kingovchouffe/CANNet/OBD2_Screen/OBD2_Screen.kicad_pcb

## KiCad design OBD2_Screen/OBD2_Screen.kicad_pcb (2023-04-28)

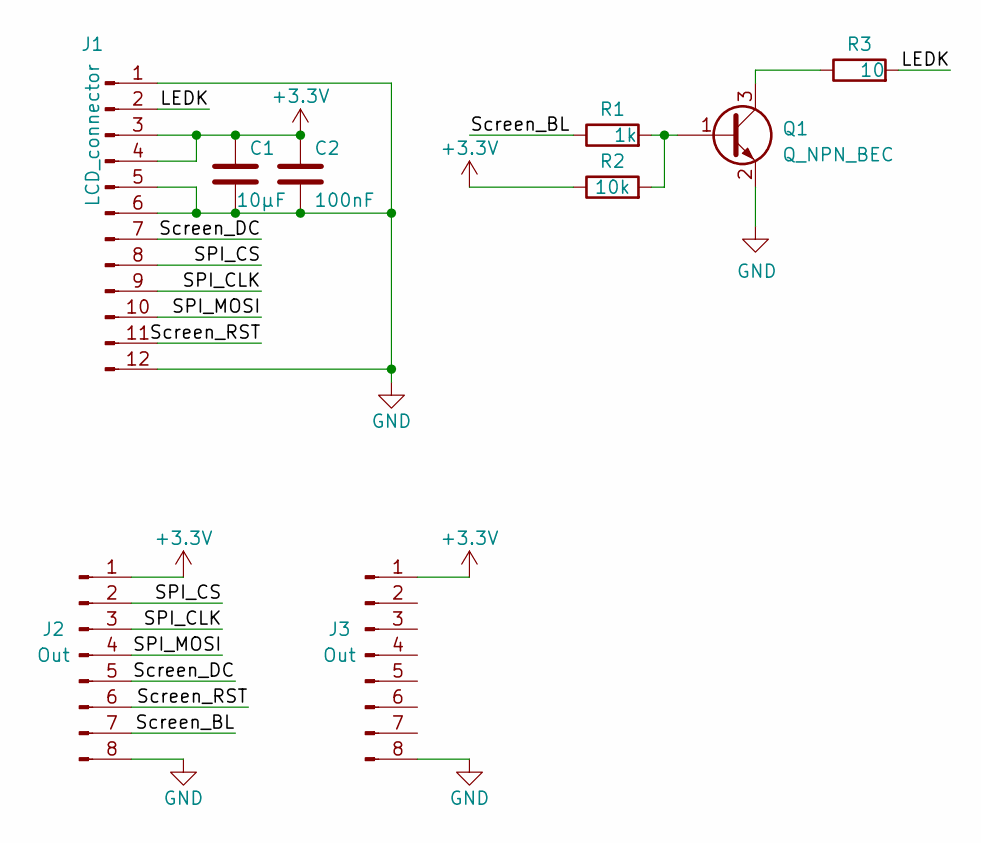
[picture p1: schematic OBD2_Screen.kicad_sch]

Parts:
C1: 10µF; C_0805_2012Metric
C2: 100nF; C_0603_1608Metric
J1: LCD_connector; FPC_12
J2, J3: Out; WR-MM Female 8pin
Q1: Q_NPN_BEC; SOT-23
R1: 1k; R_0603_1608Metric
R2: 10k; R_0603_1608Metric
R3: 10; R_0603_1608Metric

Connections:
+3V3: C1.2, C2.2, J1.3, J1.4, J2.1, J3.1, R2.1
/LEDK: J1.2, R3.2
/SPI_CLK: J1.9, J2.3
/SPI_CS: J1.8, J2.2
/SPI_MOSI: J1.10, J2.4
/Screen_BL: J2.7, R1.1
/Screen_DC: J1.7, J2.5
/Screen_RST: J1.11, J2.6
GND: C1.1, C2.1, J1.1, J1.5, J1.6, J1.12, J2.8, J3.8, Q1.2 (E)
unnamed: Q1.1 (B), R1.2, R2.2
unnamed: Q1.3 (C), R3.1

Board: 2 copper layers, 9 parts (0 on the bottom side), 11 nets, no tracks yet.
