kingovchouffe/CANNet/Motherboard/Motherboard.kicad_pcb

## KiCad design Motherboard/Motherboard.kicad_pcb (2023-04-28)

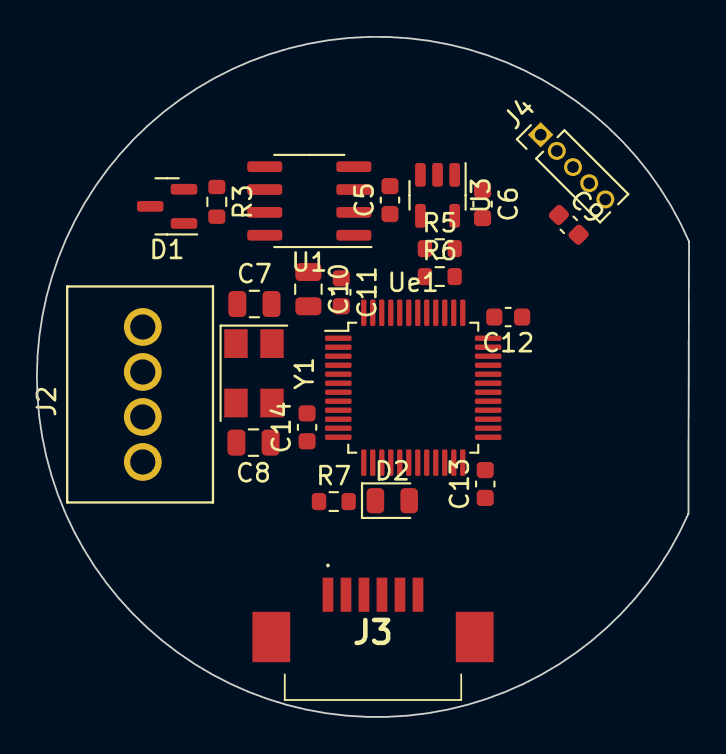
[picture p2: board Motherboard.kicad_pcb from above]

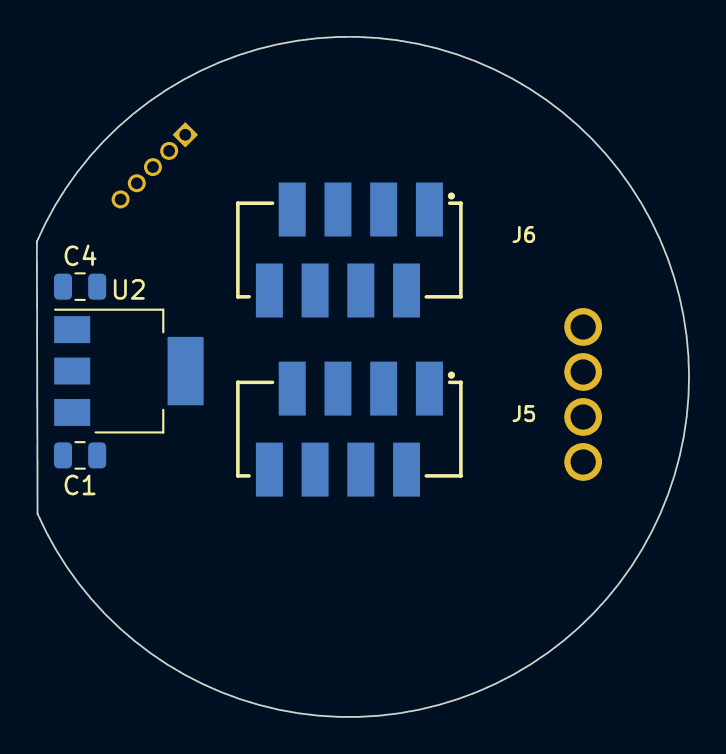
[picture p3: board Motherboard.kicad_pcb from below]

Board: 4 copper layers, 36.2 x 37.8 mm, 28 parts (5 on the bottom side), 23 nets, no tracks yet.

Parts:
C1, C4: 10u; C_0805_2012Metric
C5, C6, C11, C12, C13, C14: 100nF; C_0603_1608Metric
C7, C8: 18p; C_0805_2012Metric
C9: 100n; C_0603_1608Metric
C10: 10µF; C_0805_2012Metric
D1: D_TVS_x2_AAC; SOT-23
D2: LED_DEBUG; LED_0805_2012Metric
J2: IO; 691382000004
J3: Encoder; flex connector
J4: SWD_Connector; PinHeader_1x05_P1.27mm_Vertical
J5, J6: Out; WR-MM 8pin Male
R3, R7: 120; R_0603_1608Metric
R5, R6: 2k; R_0603_1608Metric
U1: SN65HVD232; SOIC-8_3.9x4.9mm_P1.27mm
U2: NCP1117-3.3_SOT223; SOT-223-3_TabPin2
U3: SOT-23-5
Ue1: STM32F302C6Tx; LQFP-48_7x7mm_P0.5mm
Y1: 8MHz; Crystal_SMD_5032-4Pin_5.0x3.2mm

Connections:
+3V3: C4.2, C5.2, C6.2, C10.2, C11.2, C12.2, C13.2, C14.2, J3.1, J4.1, J5.1, J6.1, R5.2, R6.2, U1.3 (VCC), U2.2 (VO), U3.5 (V_{CC}), Ue1.9 (VDDA), Ue1.24 (VDD), Ue1.36 (VDD), Ue1.48 (VDD)
+12V: C1.2, J2.1, U2.3 (VI)
/CANH: D1.1 (A1), J2.3, R3.2, U1.7 (CANH)
/CANL: D1.2 (A2), J2.4, R3.1, U1.6 (CANL)
/Encoder_A: J3.3, Ue1.11 (PA1)
/Encoder_B: J3.4, Ue1.12 (PA2)
/Encoder_Button: J3.5, Ue1.13 (PA3)
/I2C_SCL: R6.1, U3.1 (SCL), Ue1.42 (PB6)
/I2C_SDA: R5.1, U3.3 (SDA), Ue1.43 (PB7)
/RST: C9.1, J4.4, Ue1.7 (NRST)
/SPI_CLK: J5.3, Ue1.26 (PB13)
/SPI_CS: J5.2, Ue1.25 (PB12)
/SPI_MOSI: J5.4, Ue1.28 (PB15)
/SWCLK: J4.3, Ue1.37 (PA14)
/SWDIO: J4.2, Ue1.34 (PA13)
/Screen_BL: J5.7, Ue1.31 (PA10)
/Screen_DC: J5.5, Ue1.29 (PA8)
/Screen_RST: J5.6, Ue1.30 (PA9)
GND: C1.1, C4.1, C5.1, C6.1, C7.2, C8.2, C9.2, C10.1, C11.1, C12.1, C13.1, C14.1, D1.3 (common), J2.2, J3.2, J3.6, J4.5, J5.8, J6.8, R7.1, U1.2 (GND), U2.1 (GND), U3.2 (V_{SS}), Ue1.8 (VSSA), Ue1.23 (VSS), Ue1.35 (VSS), Ue1.47 (VSS), Y1.2, Y1.4
unnamed: D2.2 (A), Ue1.18 (PB0)
unnamed: D2.1 (K), R7.2
unnamed: C7.1, Ue1.5 (PF0), Y1.1
unnamed: C8.1, Ue1.6 (PF1), Y1.3
